yenescaliskan/-Sound-Level-Detector/term project.asc

C1: cap; 470µ
C2: cap; 47µ
D1: diode
D2: diode
D3: diode
D4: diode
D5: LED
R1: res; 1k
R2: res; 10k
R3: res; 10k
R4: res; 1k
R5: res; 10k
R6: res; 1k
R7: res; 1k
R8: res; 1k
R9: res; 1k
R10: res; 1k
R11: res; 10k
R12: res; 10k
R13: res; 10k
R14: res; 10k
R15: res; 10k
R16: res; 11k
R17: res; 1k
R18: res; 1.5k
R19: res; 10k
U1: UniversalOpamp2
U2: UniversalOpamp2
U3: UniversalOpamp2
U4: UniversalOpamp2
U5: UniversalOpamp2
U6: UniversalOpamp2
U7: UniversalOpamp2
U8: UniversalOpamp2
V1: voltage; SINE(0 0.012 750)
V2: voltage; 12
V3: voltage; 12
V4: voltage; 6
V5: voltage; 6
V6: voltage; 6
Named nets: 0, +12, -12, +6, -6
.tran 0 35 30
